ncm88/BART/images/squarecap.png

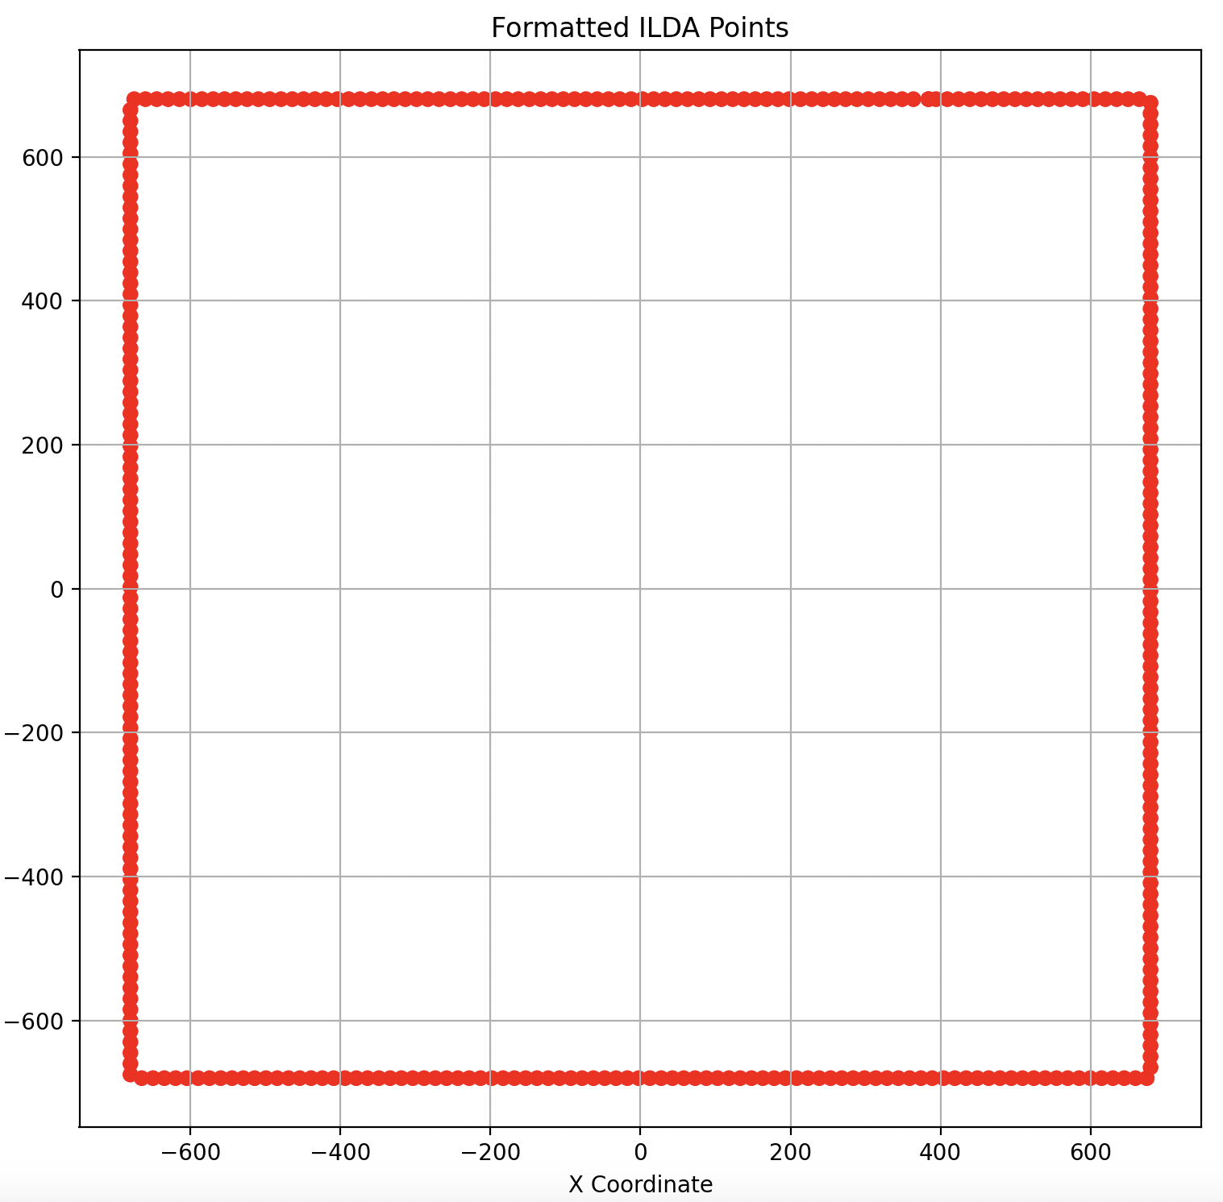
images/squarecap.png
