ncm88/BART/images/trianglecontcap.png

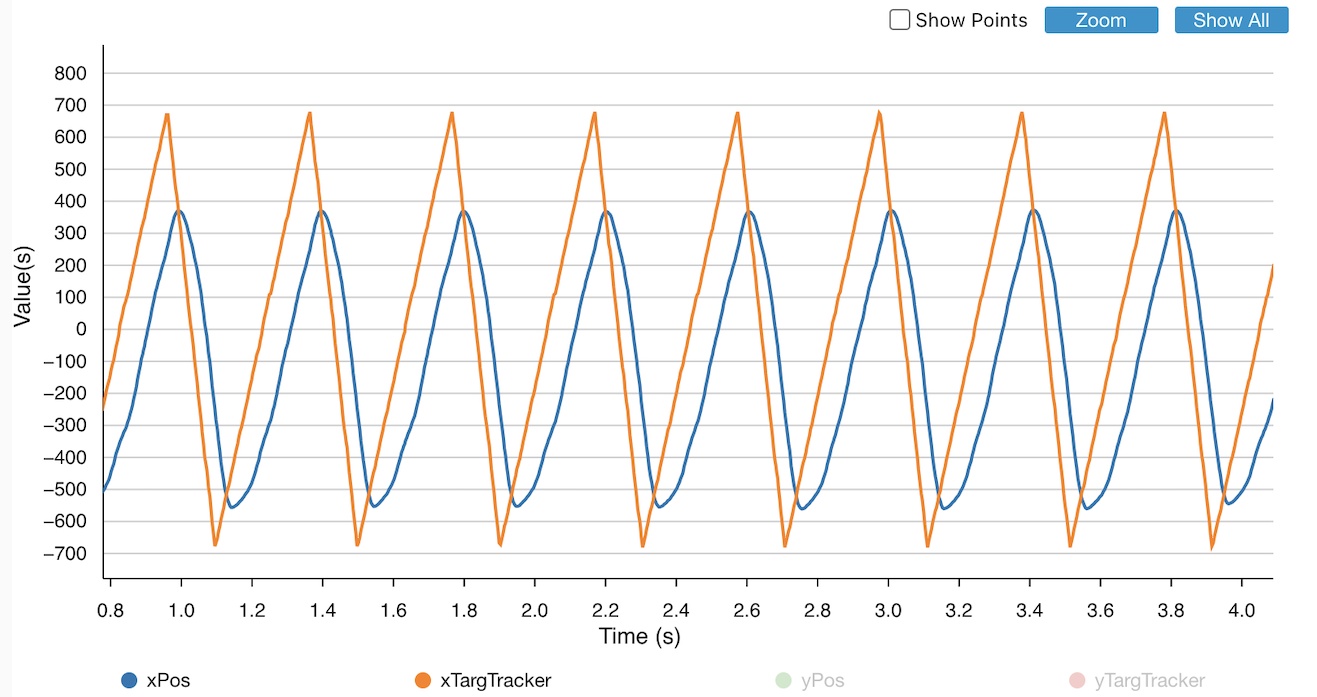
images/trianglecontcap.png
