ncm88/BART/(commit log)

2024-03-07 add encoder and filter modules
2024-03-07 add pid module
2024-03-07 add timer callback for PID control
2024-03-09 timer interrupt test at 1s pulse
2024-03-10 first working adc sampler
2024-03-13 working encoder reader
2024-03-13 pre working avg filter
2024-03-13 working average filter
2024-03-13 add EMA filter
2024-03-13 add ema filter comparison test
2024-03-16 fix pd algo and update pwm timers
    [BART_3.ioc, main.c, main.h, pd.h]
2024-03-26 fix tim6 count issue
    [BART_3.ioc, main.c, main.h, pd.c, pd.h]
2024-03-30 debug up to faulty resolution and encoder timer overflow
2024-04-03 add test code for two motors with randomized targets
2024-04-03 pinout rework to add homing
    [BART_3.ioc, main.c]
2024-04-04 servotest first merge
2024-04-05 add timer-driven uart poll isr prototype
2024-04-07 initial uart ilda stream setup
2024-04-07 2khz control freq rework, refine isr, remove bloat, add fsm skeleton
    [BART_3.ioc, main.c, main.h, pd.c]
